AI-FanGe/RobotDuck_Head_Esp32/3Dprint/鸭嘴柔性tpu.3mf

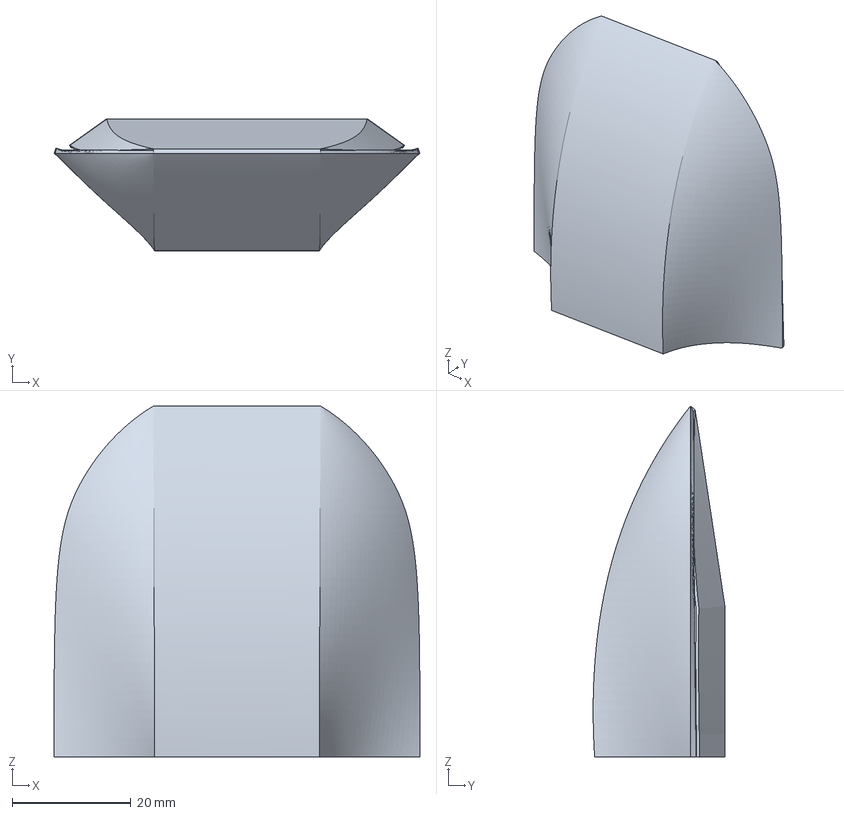
[picture p1: CAD file, 2025-12-31]
3Dprint/鸭嘴柔性tpu.3mf
61.7 x 22.2 x 59.1 mm
