AI-FanGe/RobotDuck_Head_Esp32/3Dprint/主要部件pla.3mf

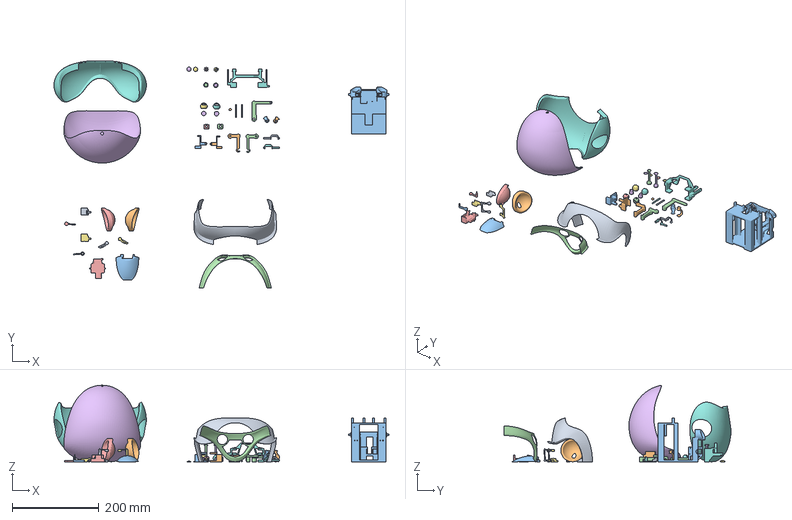
[picture p2: CAD file, 2025-12-31]
3Dprint/主要部件pla.3mf
770.8 x 522.9 x 176.1 mm
12.obj x 3
11f.obj_2
a.obj
e.obj
11f.obj_1
31.obj
j.obj
2.obj
i.obj
3.obj x 2
111.obj
4.obj
8.obj x 2
5.obj x 2
6.obj x 2
k.obj
7.obj
g.obj
h.obj
9.obj x 2
10.obj
11.obj
14.obj x 2
15.obj
16.obj
18.obj
17.obj
b.obj
c.obj
f.obj x 2
cdc.obj
