AI-FanGe/RobotDuck_Head_Esp32/(commit log)

2025-12-31 Initial commit: RobotDuck Head ESP32 project
2025-12-31 Add 3D print files
    [主要部件pla.3mf, 鸭嘴柔性tpu.3mf]
